horohoro/Solarpunk/enclosure/README.md

# 3.0mm Laser-Cut Enclosure Guide

This enclosure houses the **ESP32 DevKit**, the **28BYJ-48 Stepper Motor**, the **ULN2003 Driver Board**, and the **12mm Push Button** in a vertical orientation mounted flat against the side of a wardrobe or closet.

Laser Cut Layout Preview

---

## 🎯 Mechanical Refinements Implemented

### 1. Inset Base Tabs on Side Walls (Zero Corner Binding)
- **The Issue**: Previously, the side walls had base tabs right at the corner, creating an awkward double-tab "L-notch" where vertical side tabs and bottom base tabs met. In 3D assembly, tabs in two perpendicular directions at the exact corner lock each other out and bind.
- **The Solution (Inset Tabs)**:
  - Both bottom corners of the side walls are now **completely flat for 14.0 mm**.
  - The base tabs are shifted into the mid-span: **two 18.0 mm tabs** separated by a 10 mm gap.
  - The Base Plate mortises match this inset position (`y = 32..50 mm` and `y = 60..78 mm`), leaving **14 mm of solid wood** at all corners of the base plate.
  - **Assembly Benefit**: The 4 perimeter walls assemble into a square ring first via their horizontal finger joints, and then the ring drops straight down into the base plate smoothly with zero binding!

### 2. Strict 450 mm × 300 mm Plank Boundaries
- All 8 parts are arranged in a spacious 3-row layout:
  - **Row 1**: Base Plate (146 × 80 mm), Front Lid (103.5 × 73.5 mm), Left Wall (74 mm body).
  - **Row 2**: Top Face (110 × 55 mm), Bottom Face (110 × 55 mm), Right Wall (74 mm body).
  - **Row 3**: Internal Divider (74 × 46.5 mm), 3x Link Pins (96 mm long).
- **Safe Margins**: Max X = **382 mm** (68 mm right margin), Max Y = **281 mm** (19 mm bottom margin).

### 3. Side Walls Body Length Corrected
- Body length is **74.0 mm** (inner span between Front and Back walls). Outer span with tabs is **80.0 mm**, sitting completely flush with zero overhang.

### 4. Front Plate / Removable Lid Resized for Internal Fit
- Resized to **103.5 mm × 73.5 mm** (`rx = 1.0 mm`), leaving 0.5 mm total clearance inside the 104 × 74 mm cavity.

### 5. 100% Square Orthogonal Finger Joints
- All finger joints and tab steps are 90-degree orthogonal cuts with zero 45-degree diagonal chamfers.

### 6. Motor Mount Screw Holes Enlarged for M4
- Enlarged to **4.2 mm diameter** (`r = 2.1 mm`) for standard M4 screws with the accurate 8.0 mm shaft offset.

### 7. Laser-Cut Precision Spool Kit (28BYJ-48 D-Shaft)
- **The Issue with Sewing Bobbins**: Standard sewing bobbins have a 6.2 mm round hole and slip freely on the 5 mm motor shaft unless modified with tape or hot glue.
- **The Solution**: Included right on the 450 × 300 mm sheet is a **complete 4-layer interlocking wooden spool kit**:
  - **Symmetric Flanges (2x 3mm wood)**: Both outer flanges feature the exact 5.0 mm × 3.0 mm D-shaft keyway and knot capture holes. The spool is **100% reversible**—you can mount it in either direction.
  - **Dual Core Disks (2x 3mm wood = 6 mm groove width)**: 15 mm diameter barrels with matching D-shaft keyways and cord pass-through holes. Together with the flanges, they provide full wood contact across the metal flats.
  - **Bottom/Inner Knot Mounting (Reduced Shaft Torque)**: Anchoring the knot on the inside flange (nearest the motor face) keeps the pulling force close to the gearbox bearing, minimizing cantilever twisting/bending stress on the shaft.
  - **Toothpick Alignment Dowels**: All disks feature two 2.2 mm holes. Push standard toothpicks through the holes during glue-up to guarantee concentric alignment, then snip flush.
  - **Spacer Washers (3mm wood)**: 9 mm OD / 5.5 mm ID washers that sit between the motor face and the spool, keeping the rotating spool safely 3 mm away from the box wall and giving room for the inner knot. Includes 1 spare washer and 1 spare core disk.

---

## 📐 Laser Cut Parameters

| Parameter | Value | Notes |
| :--- | :--- | :--- |
| **Plank Dimensions** | 450 mm × 300 mm | Standard plywood / MDF / basswood plank |
| **Active Cut Extents** | 382 mm × 281 mm | Generous 68mm right & 19mm bottom clearance |
| **Material Thickness** | 3.0 mm | Standard laser plywood / acrylic / MDF |
| **Vector Cut Lines** | `#FF0000` (Red) | 0.001 in (0.1 mm hairline), Vector Mode |
| **Raster Engravings** | `#000000` (Black) | Raster Mode (Text labels, logo, and pin guides) |

---

## 🛠️ Assembly Sequence

```mermaid
flowchart TD
    A["1. Base Plate: Screw 4x to Closet Side"] --> B["2. Mount ULN2003 & Divider into Base"]
    B --> C["3. Assemble 4 Perimeter Walls into a Ring (Horizontal Tabs)"]
    C --> D["4. Drop 4-Wall Ring straight down into Base Plate (Inset Tabs)"]
    D --> E["5. Mount 28BYJ-48 Motor & 12mm Push Button"]
    E --> F["6. Assemble Wooden Spool: Glue 4 disks with toothpicks"]
    F --> G["7. Slide Spacer Washer + Spool onto Motor D-Shaft"]
    G --> H["8. Slide Front Plate (103.5 x 73.5mm) inside 4 walls"]
    H --> I["9. Drop 2x T-Pins from Top to Bottom (Hang by Gravity)"]
```
