horohoro/Solarpunk/enclosure/curtain_case_3mm.dxf

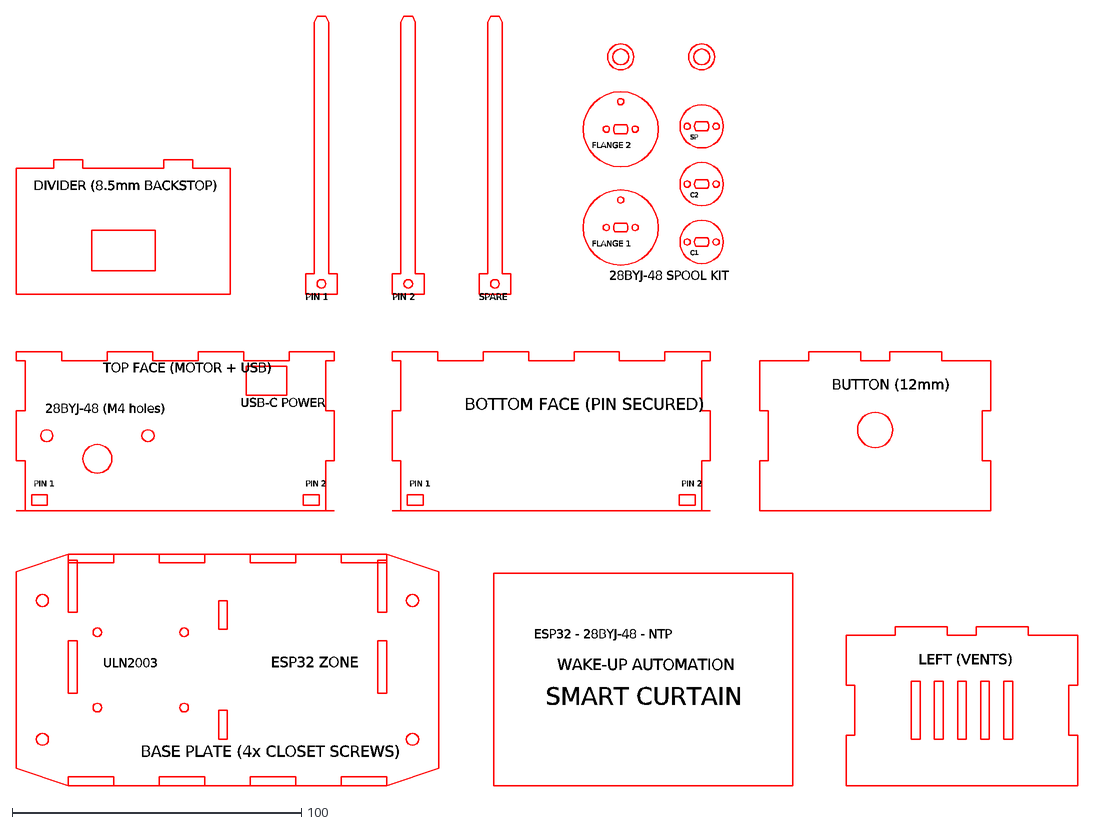
[picture p2: CAD file, 2026-10-31]
enclosure/curtain_case_3mm.dxf
ULN2003
ESP32 ZONE
BASE PLATE (4x CLOSET SCREWS)
SMART CURTAIN
WAKE-UP AUTOMATION
ESP32 - 28BYJ-48 - NTP
LEFT (VENTS)
PIN 1
PIN 2
28BYJ-48 (M4 holes)
USB-C POWER
TOP FACE (MOTOR + USB)
BOTTOM FACE (PIN SECURED)
BUTTON (12mm)
DIVIDER (8.5mm BACKSTOP)
SPARE
28BYJ-48 SPOOL KIT
FLANGE 1
FLANGE 2
C1
C2
SP
