horohoro/Solarpunk/(commit log)

2026-10-31 Initial commit: Solarpunk
    [curtain_case_3mm.dxf]
2026-10-31 Add laser-cut 28BYJ-48 precision wooden spool kit to enclosure
    [curtain_case_3mm.dxf]
2026-10-31 Streamline enclosure layout to a single precision 28BYJ-48 spool
    [curtain_case_3mm.dxf]
2026-10-31 Make spool fully reversible with matching D-shaft keyways and dual knot anchors
    [curtain_case_3mm.dxf]
2026-10-31 Align all spool alignment and knot holes to identical 5.0mm pitch across all layers
    [curtain_case_3mm.dxf]
2026-10-31 Position knot catch hole on flange winding wall (9.5mm) outside core barrel
    [curtain_case_3mm.dxf]
2026-11-02 Implement instant interruptible button toggle and tunable slack release
2026-11-02 Update default pull revolutions to 12 and slack to 10 to prevent fabric packing stall
    [CurtainOpener.ino]
2026-11-02 Restore strictly symmetrical 1:1 rev and unrev (zero net drift)
    [CurtainOpener.ino]
2026-11-03 Fix alarm scheduler: allow same-day tests and tighten check to 1 second
    [CurtainOpener.ino]
